psytraxx/gravity-cube-espidf/README.md

# Gravity Cube (ESP-IDF)

Firmware for an 8x8x8 LED cube whose particles fall the way the cube is
tilted. Tilt it and the fluid flows downhill; shake it and the fluid
sloshes; spin it and the fluid swirls against the spin and out to the
walls. A double tap gives the fluid a new, random colour.

It runs on an ESP32-S3 (ESP32-S3 SuperMini) with a BMI160 IMU and
six 8x8 WS2812 panels, and is written in C for ESP-IDF 6.1. The physics is
a port of the fluid solver in
[gravity-cube-rs](https://github.com/psytraxx/gravity-cube-rs).

## Hardware

| Part | Notes |
|---|---|
| ESP32-S3 SuperMini | ESP32-S3FH4R2: 4 MB flash, 2 MB PSRAM (not used) |
| BMI160 breakout | 12-pin board (VIN, 3V3, GND, SCL, SDA, CS, SA0, …), wired for SPI |
| 6 × 8x8 WS2812B panels | 384 LEDs in one chain |
| 330 Ω resistor | In series with the data line, at the first panel |
| 1500 µF capacitor | Across 5 V and GND at the first panel (10 V or more), against the inrush when the LEDs switch |
| 1N5819 Schottky diode | From the 5 V supply to the SuperMini's 5V pin, so USB cannot feed the LEDs or the supply |
| INMP441 breakout | I2S microphone, 1.8–3.3 V; wired, but the firmware does not read it |
| 5 V supply | Sized for the LEDs; the firmware keeps them dim (one channel at 60/255 or less) |

## Wiring

Wiring

### Power

The 5 V supply feeds the panels directly and the SuperMini through the
1N5819, anode on the supply, cathode (the band) on the board's 5V pin.
As a Schottky it drops about 0.3 V at the board's current, so the
SuperMini's regulator gets about 4.7 V. With USB plugged in as well, the
diode keeps USB's 5 V out of the supply and the LEDs; the board then runs
from whichever is higher. The 1500 µF
capacitor sits across 5 V and GND where the supply meets the first
panel, + to 5 V. All grounds are common.

### LEDs

| SuperMini | Goes to |
|---|---|
| GPIO 2 | 330 Ω → DIN of panel 0 |

The panels chain OUT to IN. The four side panels run round the cube, each
with IN at the bottom of the edge it shares with the previous panel. Inside
a panel the chain runs one of two ways, set by *Panel wiring* in
menuconfig:

- **Rows** (default): along the bottom row, then each row above it from the
  same side, to OUT at the top of the edge with the next panel.
- **Zigzag columns**: up the first column, down the next and so on, to OUT
  at the bottom of the edge with the next panel.

Top and Bottom keep their IN corner and turn the same way.

```mermaid
flowchart LR
    ESP[GPIO 2] --> P0["0 Left (x = 0)"] --> P1["1 Back (y = 0)"] --> P2["2 Right (x = 7)"]
    P2 --> P3["3 Front (y = 7)"] --> P4["4 Bottom (z = 0)"] --> P5["5 Top (z = 7)"]
```

The per-panel rotation and mirroring is in
[`main/core/panel.c`](main/core/panel.c).

### BMI160 (SPI)

The IMU uses GPIO 10–13, the ESP32-S3's SPI2 IOMUX pins, and GPIO 9 for
its interrupt line, all on the SuperMini's header:

| BMI160 board | SuperMini |
|---|---|
| 3V3 | 3V3 |
| GND | GND |
| SCL (SCK) | GPIO 12 (SPI_CLK) |
| SDA (SDI / MOSI) | GPIO 11 (SPI_D) |
| SA0 (SDO / MISO) | GPIO 13 (SPI_Q) |
| CS (CSB) | GPIO 10 (SPI_CS) |
| INT1 | GPIO 9 |

VIN (into the board's regulator), INT2 and the auxiliary pins (OCS,
SCX, SDX) stay unconnected. INT1 is push-pull at 3.3 V, so it needs no
resistor. The chip starts on I2C; the first rising edge on CS switches
it to SPI until it is power cycled. SPI runs at 1 MHz (the chip takes
up to 10 MHz). The pins are settable in menuconfig.

### INMP441 microphone (I2S)

| INMP441 board | SuperMini |
|---|---|
| VDD | 3V3 |
| GND | GND |
| SCK | GPIO 5 (I2S bit clock) |
| WS | GPIO 6 (I2S word select) |
| SD | GPIO 7 (I2S data) |
| L/R | GND (left channel) |

The firmware does not read the microphone. The ESP32-S3 routes I2S to any
GPIO, so these pins are just free ones next to each other on the header,
clear of the strapping pins.

### Mounting

The IMU board lies flat on the top face with its Z axis pointing up and
its X axis along the cube's x axis. Mounted any other way, edit
`BMI160_AXIS_MAP` in [`main/core/bmi160_decode.h`](main/core/bmi160_decode.h):
if tilting moves the fluid the wrong way on an axis, flip that axis' sign.

## Build and flash

ESP-IDF 6.1 ([install guide](https://docs.espressif.com/projects/esp-idf/en/v6.1/esp32s3/get-started/)):

```bash
idf.py build
idf.py -p /dev/ttyACM0 flash monitor
```

### Assembly pattern

To check that every panel sits on its face the right way round while
putting the cube together, turn on *Assembly pattern instead of the
fluid* in menuconfig. The cube then shows a still pattern for good:

- The 4x4 centre of each panel glows in that panel's own colour.
- Each edge strip (corners dark) glows in the colour of the panel on the
  other side of that edge.

| Panel | Own colour |
|---|---|
| 0 Left | red |
| 1 Back | green |
| 2 Right | blue |
| 3 Front | yellow |
| 4 Bottom | magenta |
| 5 Top | white |

On a correctly built cube every edge strip matches the centre of the
panel beside it, so along each seam the two strips swap colours. A wrong
centre colour means a panel on the wrong face; edge colours on the wrong
sides mean a panel turned or flipped. The monitor logs the colour table
at startup. Turn the option off again for the fluid.

Keep the cube still for the first second after power on: the gyro
calibrates its zero offset then.

The monitor logs a status line every 100 frames: acceleration,
rotation rate, and the physics, frame and LED send times.

## Updates over Wi-Fi

Once the cube has been flashed over USB with a Wi-Fi SSID set, it takes
new firmware over the network. Set the SSID and password (and, ideally,
an update token) in `idf.py menuconfig` → *Gravity cube* → *Wi-Fi and
firmware updates*, flash over USB once, then for every update:

```bash
idf.py build
curl -H "Authorization: Bearer $TOKEN" \
     --data-binary @build/gravity-cube.bin http://cube.local/ota
```

`curl http://cube.local/` shows the running version (from `git
describe`) and app slot. If `cube.local` does not resolve, use the IP
address the monitor logs once Wi-Fi is up.

```mermaid
sequenceDiagram
    participant PC
    participant Cube
    participant Boot as Bootloader
    PC->>Cube: POST /ota (app image)
    Cube->>Cube: write image to the other slot, check it
    Cube-->>PC: Update written, restarting
    Cube->>Boot: restart
    Boot->>Cube: boot new image (pending)
    Cube->>Cube: Wi-Fi up and 100 frames run within 2 min?
    alt yes
        Cube->>Boot: keep new image
    else no, or it crashes first
        Boot->>Cube: boot previous image
    end
```

The 4 MB flash has two 1984 KB app slots ([`partitions.csv`](partitions.csv)):
the running firmware writes the new image into the other one and boots
it. A new image only stays if it gets onto the network and runs the main
loop for 100 frames within two minutes; if not, or if it crashes first,
the bootloader goes back to the previous image. So a broken build cannot
cut the cube off from further updates, but one built with no SSID turns
updates off for good, until the next USB flash.

Wi-Fi, the network stack and the update server run on core 1, next to
the LED task, so the physics on core 0 keeps its time. Flash writes
pause both cores for moments at a time, so the fluid stutters for the
few seconds an update takes.

Without a token, anyone on the network can reflash the cube.

## Settings

`idf.py menuconfig` → *Gravity cube*:

| Setting | Default | |
|---|---|---|
| LED data GPIO | 2 | |
| Panel wiring | Rows | Rows or zigzag columns, see [LEDs](#leds) |
| Physics step period | 18 ms | The physics constants are per step; a fluid step takes ~17 ms, so 18 ms (55 fps) is the shortest it keeps up with |
| Assembly pattern | off | A still pattern instead of the fluid, for putting the panels in, see [Assembly pattern](#assembly-pattern) |
| Tap threshold | 1000 mg | In 125 mg steps. Raise it if sloshing changes the colour, lower it if taps are missed |
| IMU SPI pins | 11, 13, 12, 10 | MOSI, MISO, SCLK, CS |
| IMU INT1 GPIO | 9 | Double-tap interrupt |
| Wi-Fi SSID, password | empty | Network for updates over Wi-Fi; an empty SSID turns Wi-Fi off |
| Hostname | cube | Answers at `http://cube.local/` |
| Update token | empty | Updates need `Authorization: Bearer <token>`; empty lets anyone on the network update |

The particle count and colour are in [`main/core/config.h`](main/core/config.h).

## How it works

```mermaid
flowchart LR
    IMU[BMI160 FIFO<br/>200 Hz] --> MF[motion filter]
    TAP[BMI160 tap engine] -->|double tap: random hue| FB
    MF -->|gravity + amplified motion| FX[fluid step]
    IMU -->|gyro, integrated| FX
    FX --> FB[frame builder]
    FB -->|queue| LED[LED task<br/>core 1, led_strip]
```

**Core 0** reads every IMU sample since the last frame, runs one physics
step and builds the frame. **Core 1** sends frames to the LEDs with
Espressif's [led_strip](https://components.espressif.com/components/espressif/led_strip)
component over RMT (~11.5 ms for 384 LEDs); the two overlap, and core 0 only waits if core 1
is still sending. Unchanged frames are not re-sent, so a settled cube
keeps the data line quiet.

**IMU.** The BMI160 samples accelerometer (±4 g) and gyro (±1000 °/s)
at 200 Hz into its FIFO, in headerless 12-byte frames. Each frame uses the mean acceleration and the
gyro integrated over all samples since the last frame.

**Motion filter.** A complementary filter tracks gravity: the gyro turns
the estimate as the cube tilts, and the accelerometer slowly corrects it.
Whatever acceleration is left over is the cube's own motion, and is
tripled before reaching the fluid, so shaking sloshes it but tilting does
not overshoot.

**Double tap.** The BMI160's tap engine finds them: a jump in
acceleration above the threshold, after at least 30 ms of stillness,
counts as a tap, and the 50 ms after it belong to the same tap; a second
tap within 375 ms latches a double tap and drives INT1 high. The main
loop checks the pin once a frame, and only when it is high reads and
clears the interrupt over SPI; it answers with a random hue at least 60° from the current
one. Shaking never has the stillness, so it does not
change the colour. Every hue's channels add up to 60/255, so the cube
draws the same current in any colour.

**Fluid.** An incompressible FLIP fluid: inviscid Navier-Stokes on a
staggered grid with one cell per voxel, carried by 512 particles (two per
voxel of a half-full cube). Each step the particles take gravity and the
forces of the turning cube (Euler, Coriolis, centrifugal), hand their
velocity to the grid, and a Gauss-Seidel pressure solve makes the flow
divergence-free against the walls. The particles take back the change
(80 % FLIP, 20 % PIC to damp noise), move, and are pushed apart so they
stay evenly spread; cells packed above two particles get a little
outflow, so the fluid keeps its volume. A voxel lights once the particle
density at its centre reaches 1.2 and goes dark below 0.4, so a settled
surface does not flicker. A step takes ~17 ms on the ESP32-S3.

## Enclosure

[`case/voxel-skin/`](case/voxel-skin/README.md) holds the Voxel Skin
enclosure: a translucent resin cube printed as an open box of five faces and
a lid for the front. On every face the skin, the edge bevels and the edge
walls are one 1.4 mm wall that carries the load, with 1.3 mm light baffles
inside. The USB-C socket and slide switch sit on the bottom front edge. One
generator builds two sizes:

- `65x65/`: an 86 mm cube for rigid 65 × 66 mm panels;
- `80x80/`: a 100 mm cube for flexible 80 × 80 mm panels.

`.github/workflows/pages.yml` publishes `case/` to GitHub Pages, with 3D
viewers at <https://psytraxx.github.io/gravity-cube-espidf/>.

## Code layout

| Path | |
|---|---|
| `main/main.c` | Main loop on core 0, LED task on core 1 |
| `main/ota.c` | Wi-Fi, mDNS and the update server on core 1; keeps or rolls back a new image |
| `main/bmi160.c` | BMI160 over SPI: setup, gyro calibration, FIFO reads |
| `main/ws2812.c` | WS2812 chain through the `espressif/led_strip` component (RMT) |
| `main/core/` | Everything that needs no hardware: fluid, colours, frames, the panel map and the fluid's picture on it, assembly pattern, motion filter, IMU sample decoding and batching |
| `test/host/` | Unity tests for `main/core`, run on the host |
| `case/` | Enclosure: generator, STLs and 3D viewers |

## Tests

The core has host tests (plain CMake and Unity, no ESP-IDF):

```bash
cmake -S test/host -B build-host && cmake --build build-host
ctest --test-dir build-host --output-on-failure
```

CI runs them and builds the firmware on every push.
