psytraxx/gravity-cube-espidf/case/voxel-skin/65x65/box.stl

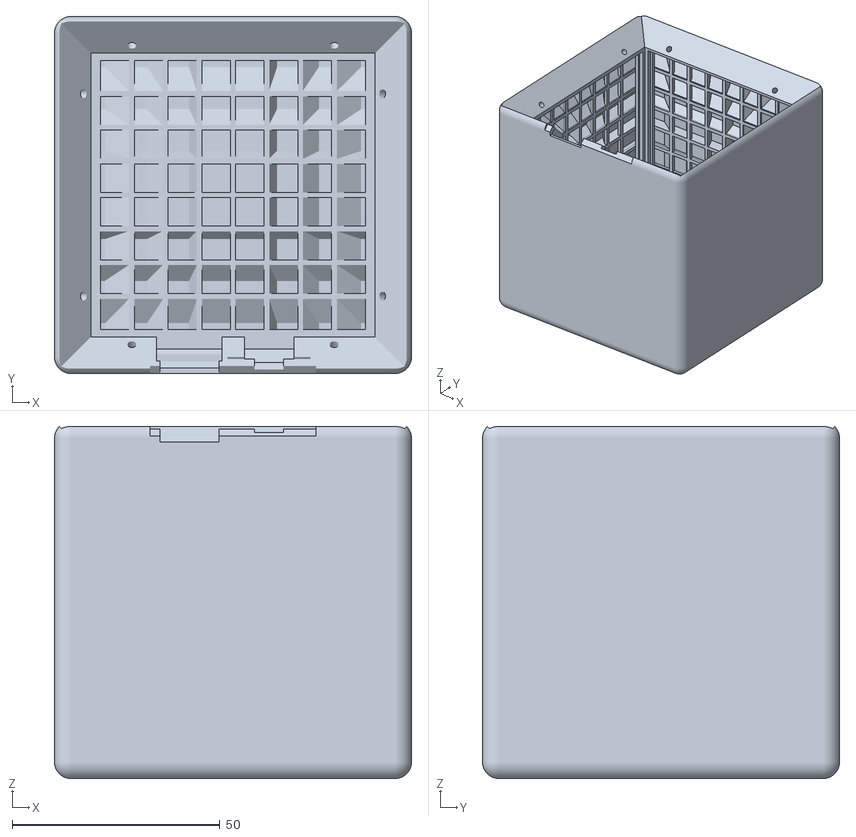
[picture p2: CAD file, 2026-11-14]
case/voxel-skin/65x65/box.stl
86.0 x 86.0 x 84.8
