psytraxx/gravity-cube-espidf/case/voxel-skin/80x80/box.stl

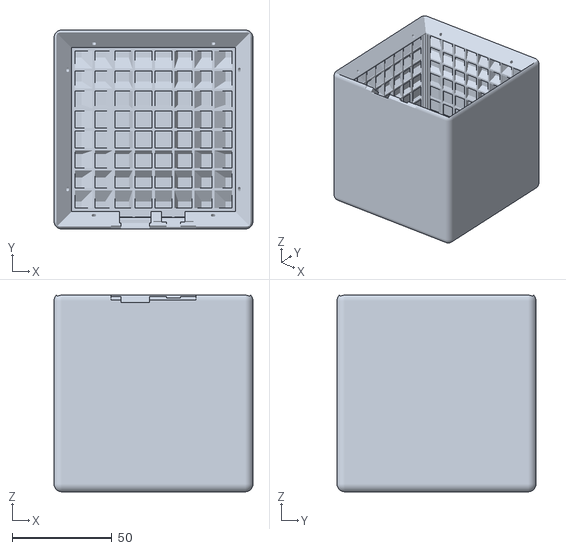
[picture p3: CAD file, 2026-11-14]
case/voxel-skin/80x80/box.stl
100.0 x 100.0 x 98.8
