psytraxx/gravity-cube-espidf/case/voxel-skin/65x65/fit_test.stl

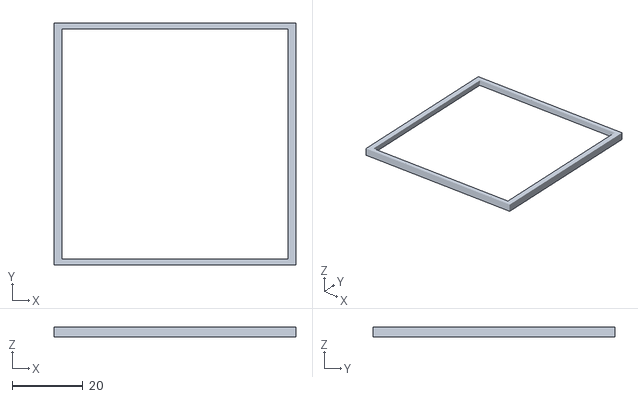
[picture p4: CAD file, 2026-11-14]
case/voxel-skin/65x65/fit_test.stl
68.2 x 68.2 x 2.90
