psytraxx/gravity-cube-espidf/case/voxel-skin/80x80/lid.stl

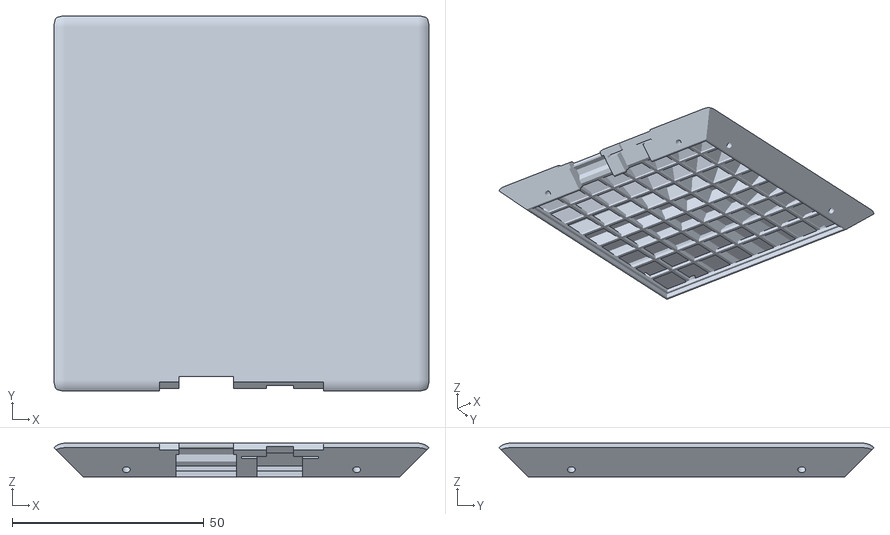
[picture p5: CAD file, 2026-11-14]
case/voxel-skin/80x80/lid.stl
97.7 x 97.7 x 8.75
