psytraxx/gravity-cube-espidf/case/voxel-skin/65x65/lid.stl

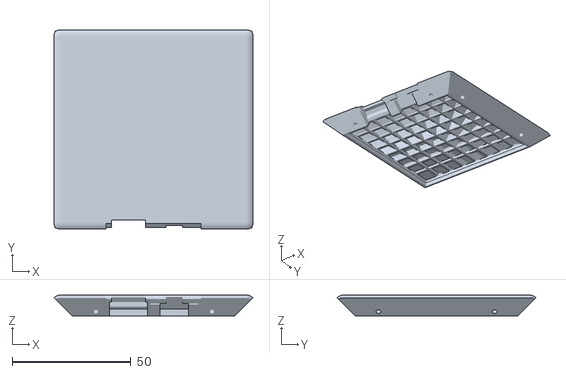
[picture p6: CAD file, 2026-11-14]
case/voxel-skin/65x65/lid.stl
83.7 x 83.7 x 8.80
