psytraxx/gravity-cube-espidf/case/voxel-skin/80x80/fit_test.stl

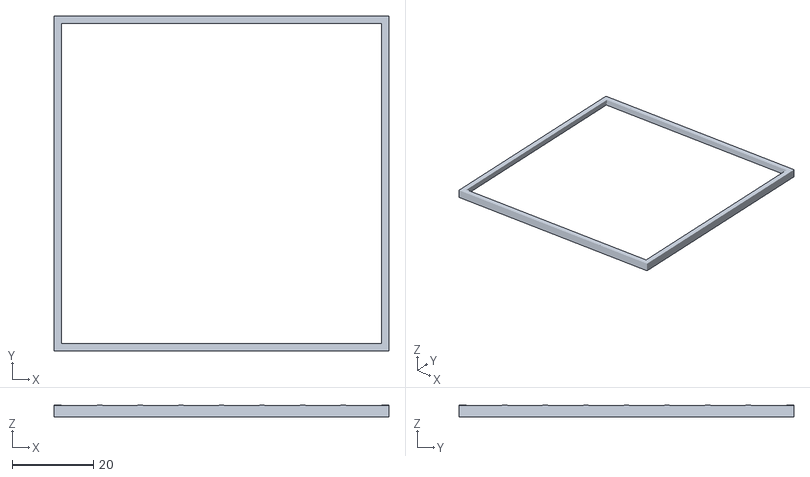
[picture p7: CAD file, 2026-11-14]
case/voxel-skin/80x80/fit_test.stl
82.5 x 82.5 x 2.85
