psytraxx/gravity-cube-espidf/case/voxel-skin/65x65/part_usb_c_lead_black.stl

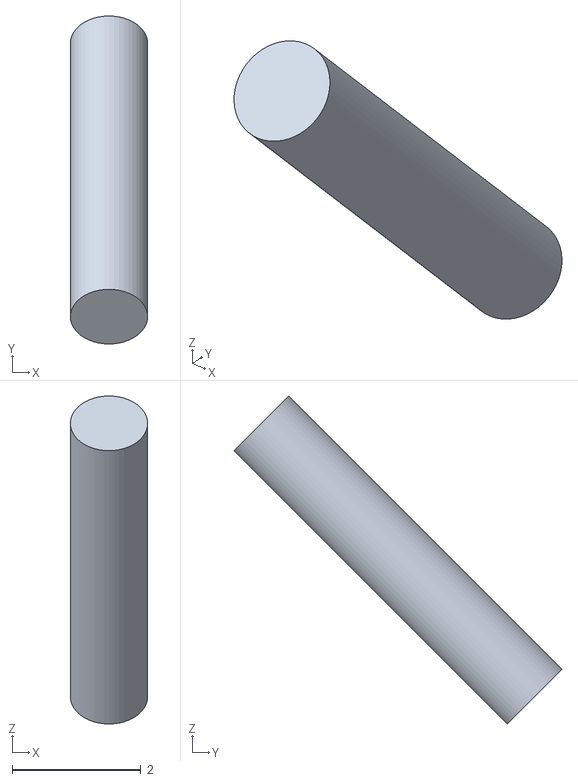
[picture p8: CAD file, 2026-11-14]
case/voxel-skin/65x65/part_usb_c_lead_black.stl
1.20 x 5.09 x 5.09
