psytraxx/gravity-cube-espidf/case/voxel-skin/80x80/part_slide_switch_ss12f15.stl

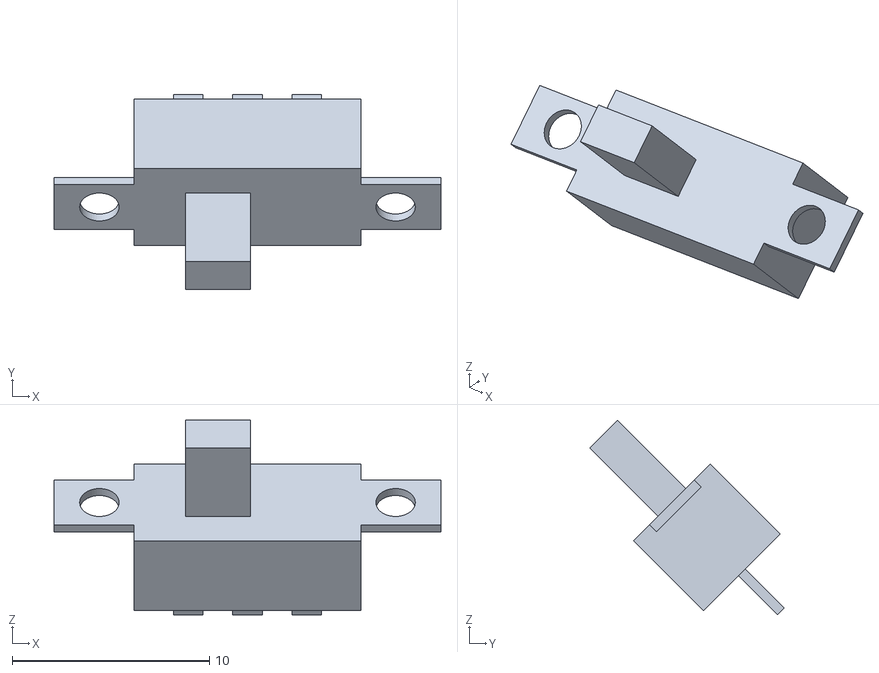
[picture p9: CAD file, 2026-11-14]
case/voxel-skin/80x80/part_slide_switch_ss12f15.stl
19.6 x 9.86 x 9.86
