psytraxx/gravity-cube-espidf/case/voxel-skin/80x80/part_usb_c_metal.stl

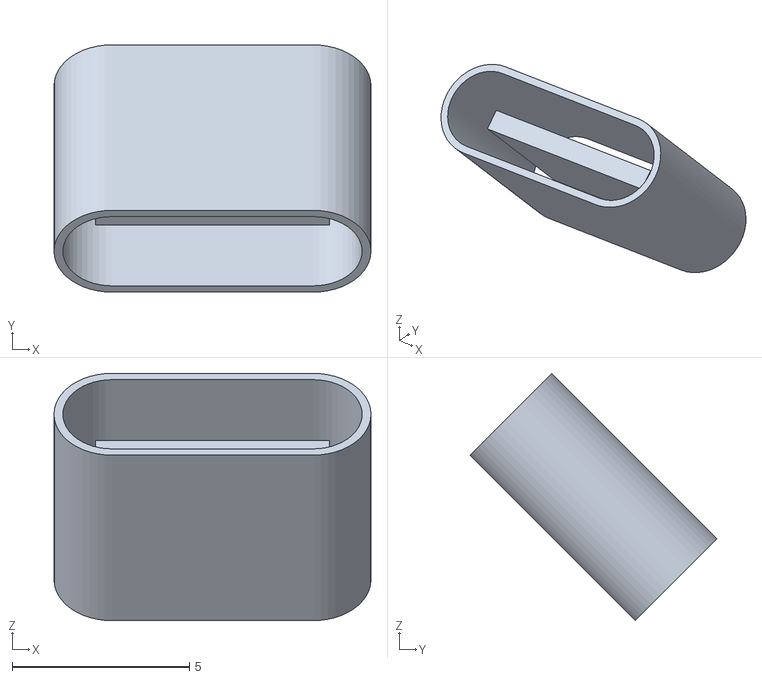
[picture p10: CAD file, 2026-11-14]
case/voxel-skin/80x80/part_usb_c_metal.stl
8.94 x 6.97 x 6.97
