psytraxx/gravity-cube-espidf/case/voxel-skin/80x80/part_usb_c_socket.stl

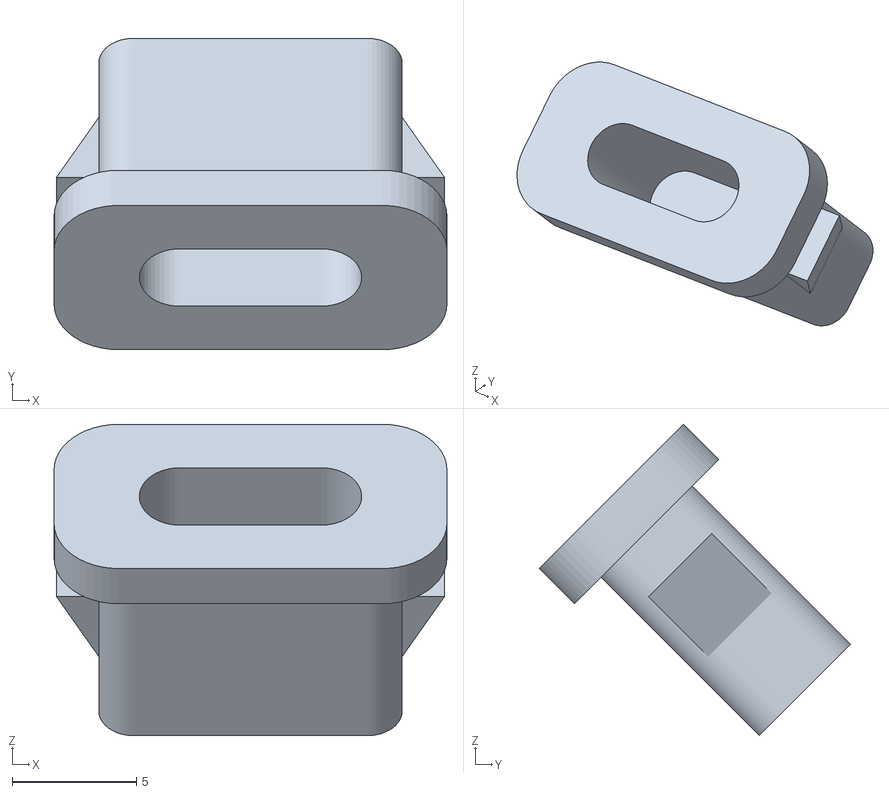
[picture p11: CAD file, 2026-11-14]
case/voxel-skin/80x80/part_usb_c_socket.stl
15.8 x 12.5 x 12.5
