psytraxx/gravity-cube-espidf/(list of files, cad)

Other CAD files:
case/voxel-skin/65x65/part_usb_c_lead_red.stl
case/voxel-skin/65x65/part_usb_c_metal.stl
case/voxel-skin/65x65/part_usb_c_socket.stl
case/voxel-skin/80x80/part_usb_c_lead_black.stl
case/voxel-skin/65x65/part_slide_switch_ss12f15.stl
case/voxel-skin/80x80/part_usb_c_lead_red.stl
