psytraxx/gravity-cube-espidf/main/main.c

/* Gravity cube: particles on an 8x8x8 LED cube that fall the way the cube
 * is tilted.
 *
 * Core 0 (this task) reads the IMU, runs the physics and builds frames;
 * core 1 sends them to the LEDs. The RMT send takes ~11.5 ms per changed
 * frame, so the two overlap: core 0 computes the next frame while core 1
 * sends the current one, and only waits if core 1 is still busy. Wi-Fi
 * and firmware updates run on core 1 too (ota.c). */
#include "assembly.h"
#include "esp_log.h"
#include "esp_random.h"
#include "esp_timer.h"
#include "fluid.h"
#include "imu.h"
#include "freertos/FreeRTOS.h"
#include "freertos/queue.h"
#include "freertos/task.h"
#include "motion.h"
#include "bmi160.h"
#include "ota.h"
#include "panel.h"
#include "sdkconfig.h"
#include "view.h"
#include "ws2812.h"

static const char *TAG = "cube";

/* Track gravity with the gyro and triple anything else, so shaking the
 * cube sloshes the fluid. */
#define MOTION_SMOOTHING 0.05f
#define MOTION_GAIN      3.0f

/* FIFO samples read per frame at most; the FIFO holds 85. */
#define MAX_SAMPLES 48

#define LOG_EVERY 100

/* Frames from core 0 to core 1. One slot. */
static QueueHandle_t s_frames;
/* Duration of the last LED send, for the status log. */
static volatile int64_t s_led_send_us;

static void led_task(void *arg)
{
    /* The RMT interrupt runs on the core that sets the channel up. */
    ESP_ERROR_CHECK(ws2812_init(CONFIG_CUBE_LED_GPIO));
    ESP_LOGI(TAG, "%d LEDs on GPIO %d, sent from core %d", LED_COUNT, CONFIG_CUBE_LED_GPIO,
             xPortGetCoreID());
    static frame_t frame;
    for (;;) {
        xQueueReceive(s_frames, &frame, portMAX_DELAY);
        const int64_t start = esp_timer_get_time();
        const esp_err_t err = ws2812_show(&frame);
        if (err != ESP_OK) {
            ESP_LOGW(TAG, "LED refresh failed: %s", esp_err_to_name(err));
        }
        s_led_send_us = esp_timer_get_time() - start;
    }
}

#if CONFIG_CUBE_ASSEMBLY_PATTERN
/* Show the assembly pattern for good. The image counts as working once
 * the pattern is out, so updates over Wi-Fi keep it. */
static void assembly_pattern(void)
{
    ESP_LOGI(TAG, "Assembly pattern: each edge shows the colour of the panel across it");
    for (int p = 0; p < PANEL_COUNT; p++) {
        ESP_LOGI(TAG, "  %d %-6s %s", p, panel_name(p), assembly_color_name(p));
    }
    static frame_t frame;
    assembly_frame(&frame);
    xQueueSend(s_frames, &frame, portMAX_DELAY);
    ota_app_ok();
    for (;;) {
        vTaskDelay(portMAX_DELAY);
    }
}
#endif

void app_main(void)
{
    ESP_LOGI(TAG, "Gravity cube, %dx%dx%d", CUBE_SIZE, CUBE_SIZE, CUBE_SIZE);

#if CONFIG_CUBE_PANEL_WIRING_ROWS
    panel_set_wiring(PANEL_WIRING_ROWS);
#else
    panel_set_wiring(PANEL_WIRING_ZIGZAG);
#endif

    /* Joins Wi-Fi on core 1 while the rest starts up. */
    ota_start();

    s_frames = xQueueCreate(1, sizeof(frame_t));
    xTaskCreatePinnedToCore(led_task, "leds", 4096, NULL, 5, NULL, 1);

#if CONFIG_CUBE_ASSEMBLY_PATTERN
    assembly_pattern();
#endif

    /* Calibrates the gyro, so the cube should be still. */
    const bool have_imu = bmi160_init() == ESP_OK;
    if (!have_imu) {
        ESP_LOGW(TAG, "No BMI160: check the wiring (README.md#wiring). "
                      "Running with gravity towards z == 0, no spin or taps.");
    }

    static fluid_t fluid;
    fluid_init(&fluid);
    fluid_populate(&fluid, FLUID_PARTICLES);
    ESP_LOGI(TAG, "%d fluid particles; double-tap the cube to change colour", FLUID_PARTICLES);
    uint32_t hue = FLUID_HUE;

    motion_filter_t motion;
    motion_filter_init(&motion, MOTION_SMOOTHING, MOTION_GAIN);

    static imu_sample_t samples[MAX_SAMPLES];
    static frame_t frame;
    /* No IMU (or no new sample): gravity towards z == 0. */
    imu_batch_t imu;
    imu_batch_init(&imu);
    uint32_t loops = 0;
    TickType_t wake = xTaskGetTickCount();

    for (;;) {
        if (have_imu && bmi160_double_tap()) {
            /* At least 60 degrees from the last hue, so the change shows. */
            hue = (hue + 60 + esp_random() % 241) % 360;
            ESP_LOGI(TAG, "Double tap: hue %lu", (unsigned long)hue);
        }

        /* Every sample since the last frame: the gyro is integrated over
         * all of them, and their mean is this frame's acceleration. */
        const int n = have_imu ? bmi160_read(samples, MAX_SAMPLES) : 0;
        if (n < 0) {
            ESP_LOGW(TAG, "IMU read failed");
        }
        imu_batch(&imu, samples, n, BMI160_SAMPLE_MS / 1000.0f);

        const int64_t start = esp_timer_get_time();
        fluid_set_rotation(&fluid, imu.rotation);
        fluid_step(&fluid, motion_filter_apply(&motion, imu.accel, imu.rotation));
        const int64_t physics_us = esp_timer_get_time() - start;

        view_frame(&fluid, hue, &frame);
        xQueueSend(s_frames, &frame, portMAX_DELAY);
        const int64_t frame_us = esp_timer_get_time() - start;

        if (++loops % LOG_EVERY == 0) {
            ESP_LOGI(TAG,
                     "Loop %lu: accel (%.2f, %.2f, %.2f) |%.2f| g, gyro (%.2f, %.2f, %.2f) rad/s, "
                     "physics %lld us, frame %lld us, LED send %lld us",
                     (unsigned long)loops, imu.accel.x, imu.accel.y, imu.accel.z, v3_len(imu.accel),
                     imu.rate.x, imu.rate.y, imu.rate.z, physics_us, frame_us, s_led_send_us);
        }
        if (loops == LOG_EVERY) {
            ota_app_ok();
        }

        /* Fixed step rate: the physics constants are per step. If a frame
         * ran over, still give the idle task a tick. */
        if (xTaskDelayUntil(&wake, pdMS_TO_TICKS(CONFIG_CUBE_FRAME_MS)) == pdFALSE) {
            vTaskDelay(1);
            wake = xTaskGetTickCount();
        }
    }
}
