psytraxx/gravity-cube-espidf/main/core/panel.h

/* Maps voxels on the cube's surface to LEDs in the chain, and builds
 * frames.
 *
 * Six 8x8 panels, chained OUT to IN. The four side panels run round the
 * cube, each with IN at the bottom of the edge it shares with the
 * previous panel. How the chain runs inside a panel is the wiring, set
 * once with panel_set_wiring. Faces are named as in the unfolded cross
 * (Front = North):
 *
 *   0 Left (x == 0), 1 Back (y == 0), 2 Right (x == 7), 3 Front (y == 7),
 *   4 Bottom (z == 0), 5 Top (z == 7)
 *
 * A voxel on an edge or corner lights an LED on every face it touches;
 * inner voxels light nothing. */
#pragma once

#include <stdint.h>

#include "config.h"
#include "frame.h"
#include "particle.h"

#define PANEL_COUNT 6
#define PANEL_LEDS  (CUBE_SIZE * CUBE_SIZE)

/* How the chain runs through each panel, from IN. On a side panel:
 *   PANEL_WIRING_ZIGZAG: up the first column, down the next and so on,
 *     to OUT at the bottom of the edge with the next panel.
 *   PANEL_WIRING_ROWS: along the bottom row, then each row above it from
 *     the same side, to OUT at the top of the edge with the next panel.
 * Top and Bottom keep their IN corner and turn the same way. */
typedef enum {
    PANEL_WIRING_ZIGZAG,
    PANEL_WIRING_ROWS,
} panel_wiring_t;

/* Before any of the functions below; PANEL_WIRING_ZIGZAG until then. */
void panel_set_wiring(panel_wiring_t wiring);

/* LEDs showing a voxel, at most three (a corner). Returns how many. */
int panel_leds(cell_t cell, uint16_t leds[3]);

/* Light every LED that shows the voxel. */
void frame_set(frame_t *f, cell_t cell, color_t color);

/* Light one LED of a panel (0-5, chain order), by where it sits seen from
 * outside the cube: column 0 on the left, row 0 at the bottom. The side
 * panels are upright and run on from one to the next round the cube; Top
 * and Bottom lie as in the unfolded cross, Top above Front and Bottom
 * below it. */
void frame_set_panel_led(frame_t *f, int panel, uint8_t col, uint8_t row, color_t color);

/* The voxel under that LED, with the same panel, column and row. */
cell_t panel_cell(int panel, uint8_t col, uint8_t row);

/* The face a panel sits on, e.g. "Back". */
const char *panel_name(int panel);
