psytraxx/gravity-cube-espidf/(commit log)

2026-10-27 Gravity cube firmware for ESP32 on ESP-IDF 6.1
    C firmware for an 8x8x8 WS2812 cube on a plain ESP32 with an MPU-6500
    IMU, carrying the fluid solver, boids, motion filter and spin response
    of gravity-cube-rs.
    - main/core: IDF-free physics, panel map, software double-tap detector
    and MPU-6500 sample decoding, with Unity host tests
    - MPU-6500 over I2C (default, GPIO 21/22) or SPI, sampled at 250 Hz
    into its FIFO, gyro bias calibrated at boot
    - LED chain on GPIO 2 (WLED default) via RMT, sent from core 1 while
    core 0 runs the physics
    - CI: host tests and firmware builds for both IMU buses
    Claude-Session: https://claude.ai/code/sessi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
2026-10-27 Talk to the MPU-6500 over SPI only
    SPI at 1 MHz reads a frame's FIFO samples in a fraction of the time the
    400 kHz I2C interface takes. Pins default to the ESP32's VSPI set
    (MOSI 23, MISO 19, SCLK 18, CS 5) and stay settable in menuconfig.
    Claude-Session: https://claude.ai/code/session_01BWpaorZbpr9YMM3qLoZtZr
2026-10-27 Drive the LEDs with Espressif's led_strip component
    ws2812.c sets the chain through espressif/led_strip (^3.1.1) on RMT,
    GPIO 2, with four RMT memory blocks for refill slack. Frames hold RGB
    per LED; led_strip orders the bytes for the wire and sends the reset
    code. dependencies.lock is regenerated by the component manager.
    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
    [panel.c, panel.h, ws2812.c, ws2812.h]
2026-10-27 Run on the ESP32-S3 and map the panels as wired
    The cube runs on a LilyGO T-Display-S3 (ESP32-S3, 16 MB flash). The IMU
    sits on the board's SPI header (MOSI 11, MISO 13, SCLK 12, CS 10), clear
    of the LCD; the LEDs stay on GPIO 2. CI builds for esp32s3.
    Panel map: the panels are zigzag wired and the four side panels run
    round the cube in columns, Left, Back, Right, Front, then Bottom and
    Top. z == 0 is the Bottom face.
    IMU axes: with these face names the cube's axes are a mirror image of
    the sensor's, so the axis map turns X round as well as Z, and the gyro
    sign is derived from the map's determinant so it always matches.
    At power on, each panel lights green for 2 s in chain order before th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
2026-10-27 Add dependencies.lock for espressif/led_strip and idf components
2026-10-27 Drop the boids; a double tap gives the fluid a random colour
    The cube runs the fluid only: main.c drives fluid_t directly, with no
    effect switching. A double tap picks a random hue at least 60 degrees
    from the current one. color_from_hue() blends two channels whose sum is
    always 60/255, so every colour draws the same current as the old dim
    green.
2026-10-28 Simulate the fluid as an incompressible FLIP fluid
    The fluid is inviscid Navier-Stokes on a staggered grid with one cell
    per voxel, carried by 512 particles (two per voxel, half the cube).
    Each step the particles take gravity and the turning cube's Euler,
    Coriolis and centrifugal forces, hand their velocity to the grid, and a
    30-pass Gauss-Seidel pressure solve makes the flow divergence-free
    against the walls. The particles take back the change (80 % FLIP,
    20 % PIC), move, and are pushed apart; cells packed above rest density
    get extra outflow so the volume holds. Grid samples past a wall get no
    weight, so cells along the walls do not read as packed.
    A voxel lights once the particle density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
    [config.h, fluid.c, fluid.h, main.c, particle.h]
2026-10-28 Tint the fluid per particle so its shades flow and mix
    Each particle carries a hue offset of up to 40 degrees either side of
    the fluid's hue, starting as a diagonal gradient across the fluid; the
    offsets travel with the particles, so sloshing swirls and mixes the
    shades. Each voxel shows its particles' density-weighted mean tint plus
    60 degrees per cell per step of speed, so moving fluid shimmers. The
    double tap still picks the base hue, and every shade keeps the same
    total brightness.
2026-10-28 Update the firmware over Wi-Fi
    The cube joins the Wi-Fi network set in menuconfig, answers at
    http://<hostname>.local/ over mDNS and takes a new app image as an HTTP
    POST to /ota, optionally guarded by a bearer token. The image goes into
    the other of two 4 MB app slots, erased as it is written so the physics
    only stalls for moments at a time.
    A new image is kept once it is on the network and the main loop has run
    100 frames within two minutes; otherwise, or if it crashes first, the
    bootloader goes back to the previous image, so a broken build cannot cut
    the cube off from updates.
    Wi-Fi, lwIP, mDNS and the HTTP server run on core 1 next to the LED
    task, leaving core 0 to the physics. The ve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
    [partitions.csv]
2026-10-28 Fill each panel LED by LED in the power-on test
    Each panel in chain order fills green from the bottom left, as seen from
    outside the cube, row by row to the top right, one LED per frame: about
    0.8 s a panel instead of 2 s, and a single dead LED shows up too. The
    sides fill upright and run on round the cube; Top and Bottom lie as in
    the unfolded cross, with their Front edge at the bottom and top.
    frame_set_panel_led() addresses one LED of a panel by that position and
    replaces frame_fill_panel().
    [main.c, panel.c, panel.h]
2026-11-05 Add the Voxel Shell enclosure and publish it to Pages
    case/ holds the enclosure for the cube: the 65x65 and 80x80 Voxel Shell
    variants with generate.py, check_fit.py, the STLs and the 3D viewers,
    plus the frame concept comparison. pages.yml publishes case/ to GitHub
    Pages on every push to main that touches it.
    Claude-Session: https://claude.ai/code/session_01BWpaosRB6kgUA5d6DK28xZ
    [assembly_preview.stl, fit_test.stl, part_slide_switch_ss12f15.stl, part_usb_c_lead_black.stl, part_usb_c_lead_red.stl, part_usb_c_metal.stl, part_usb_c_socket.stl, shell.stl]
2026-11-05 Run on the ESP32-S3 SuperMini
    The SuperMini's ESP32-S3FH4R2 has 4 MB flash, so the two app slots are
    1984 KB each and the flash size is 4 MB. Its header carries GPIO 1-13,
    so the LED and IMU pins stay as they are.
    [partitions.csv]
2026-11-05 Document the INMP441 microphone wiring
2026-11-05 Add a wiring diagram with the LED power parts
    docs/wiring.svg shows the whole cube: supply, SuperMini, LED panels,
    MPU-6500 and INMP441. The LED data line runs from GPIO 2 through the
    330 ohm resistor straight to panel 0. A 1N4007 from the supply to the
    SuperMini's 5V pin keeps USB power out of the LEDs, and a 1500 uF
    capacitor sits across the supply at the first panel.
2026-11-05 Use a BMI160 IMU over SPI
    The IMU is a BMI160 on a 12-pin breakout, on the same SPI pins. It
    samples accel (±4 g) and gyro (±1000 °/s) at 200 Hz into its FIFO as
    headerless 12-byte frames (gyro then accel, little-endian), decoded in
    main/core/bmi160_decode.c. A board that turns out to carry an ST
    LSM6DS3 is named in the log.
    Claude-Session: https://claude.ai/code/session_01BWpaoq3PrZbpeUV9RDYNTk
2026-11-05 Detect double taps with the BMI160's tap engine
    The chip's engine finds double taps: slope above the menuconfig
    threshold (125 mg steps at ±4 g), 30 ms quiet, 50 ms shock, second tap
    within 375 ms. The event is latched in INT_STATUS_0; the main loop reads
    it once a frame and clears it with INT_RESET. The software tap detector
    and its tests are gone.
    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
2026-11-05 Take the double tap from the BMI160's INT1 pin
    INT1 (push-pull, active high, latched) goes to GPIO 9, settable in
    menuconfig, with the internal pull-down on. The main loop checks the
    pin each frame and reads and clears INT_STATUS_0 over SPI only when it
    is high. README and the wiring diagram show the new line.
    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
2026-11-05 Feed the SuperMini through a 1N5819, guard INT1
    The SuperMini's 5V pin is fed through a 1N5819 Schottky diode, which
    drops about 0.3 V, so the board's regulator gets about 4.7 V.
    The IMU runs on SPI2_HOST, whose IOMUX pins GPIO 10-13 are. Register
    writes carry their two bytes in the transaction itself. A double tap
    counts on a rising edge of INT1 only, so a line stuck high changes the
    colour once rather than every frame.
    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
    [bmi160.c, bmi160.h, main.c]
2026-11-05 Add panel wiring configuration and update logic for LED chain layout
2026-11-07 Join routers with a broken WPA3 compatibility mode
    The FRITZ!Box 4040 advertises an RSNXE override element in its beacon
    but leaves it out of 4-way handshake message 3, so every join failed
    with reason 17 (IE differs in 4-way handshake). The station now ignores
    WPA3 compatibility (RSN override) elements and joins with the base RSN
    element.
    Reconnects after a dropped or failed join back off from 1 s to 60 s,
    resetting once an IP is assigned.
    [ota.c]
2026-11-07 Show an assembly pattern for fitting the panels
    With "Assembly pattern instead of the fluid" set in menuconfig, the cube
    shows a still pattern after the panel test. Each panel lights its 4x4
    centre in its own colour (Left red, Back green, Right blue, Front
    yellow, Bottom magenta, Top white) and each edge strip in the colour of
    the panel across that edge, corners dark. On a correctly built cube
    every edge strip matches the centre beside it; a wrong centre colour
    means a panel on the wrong face, edge colours on the wrong sides a panel
    turned or flipped.
    The pattern takes its geometry from the panel map through panel_cell,
    the voxel under a panel LED, which frame_set_panel_led now uses too.
    C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
    [assembly.c, assembly.h, main.c, panel.c, panel.h]
2026-11-08 Drop the power-on panel test (#11)
    At power on the cube goes straight to the fluid, or to the assembly
    pattern when that is set: the assembly pattern is the one picture for
    checking the panels.
    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
2026-11-08 Tidy the layers: frames, the fluid's picture and IMU batching in the core (#12)
    - main/core/frame.[ch] holds frame_t, frame_clear and frame_set_led; the
    panel map and the WS2812 driver build on it, so the driver no longer
    depends on the panel map. color_t lives in color.h.
    - main/core/view.[ch] turns the fluid into a frame on the panels (host
    tested); main.c calls it.
    - main/core/imu.[ch] folds a frame's IMU samples into the mean
    acceleration, the rotation over them and the last rate (host tested).
    - The BMI160 driver drops the I2C scan option and the LSM6DS3 check; the
    IMU is a BMI160 on SPI.
    Claude-Session: https://claude.a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
    [bmi160.c, color.h, config.h, frame.h, imu.h, main.c, panel.c, panel.h]
2026-11-14 Add Voxel Skin 80x80 enclosure: folded-plate shells with 1.4 mm walls
    Six mitred shells for the flexible 80 x 80 mm panels in which the skin,
    bevels and mitre walls form one 1.4 mm structural wall, with 0.85 mm
    light baffles inside. 100 mm cube, 24.3 cm3 of resin per shell, same
    panels, USB-C socket, switch and dowels as the Voxel Shell 80x80.
    Claude-Session: https://claude.ai/code/session_01BWpaosr9mWHCACSGeV29nH
    [assembly_preview.stl, fit_test.stl, part_slide_switch_ss12f15.stl, part_usb_c_lead_black.stl, part_usb_c_lead_red.stl, part_usb_c_metal.stl, part_usb_c_socket.stl, shell.stl]
2026-11-14 Replace the Voxel Shell enclosures with the Voxel Skin for both panel sizes
    case/voxel-skin/ builds six mitred translucent resin shells for the rigid
    65 x 66 mm panels (86 mm cube, 21.3 cm3 per shell) and the flexible
    80 x 80 mm panels (100 mm cube, 26.7 cm3 per shell). In each shell the skin,
    edge bevels and mitre walls are one 1.4 mm folded wall that carries the
    load; 1.3 mm baffles inside fan the light out to the mitre walls. Same
    panels, USB-C socket, switch and dowels as before.
    check_fit.py checks the fit of panels, parts and shells, outer walls of at
    least 1.3 mm and features of at least 0.8 mm. One viewer.html shows both
    sizes from the profile.json the generator writes. The index pa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
    [assembly_preview.stl, fit_test.stl, part_slide_switch_ss12f15.stl, part_usb_c_lead_black.stl, part_usb_c_lead_red.stl, part_usb_c_metal.stl, part_usb_c_socket.stl, shell.stl]
2026-11-14 Print the Voxel Skin as an open box of five faces and a lid
    The back, top, bottom, left and right faces are cut from one solid as
    box.stl; the front face is lid.stl. The eight edges inside the box are a
    single 1.4 mm wall shared by two faces, and only the four edges round the
    opening keep mitre walls and dowels (8 instead of 24). Resin drops to
    124 cm3 (65x65) and 155 cm3 (80x80).
    check_fit.py checks every panel against the box and lid, and the path each
    panel takes in through the open front: the back panel straight in, each
    side panel held 3.25 mm in from its face, slid in and pressed out into its
    pocket. The wall check now covers the shared edge walls too. The viewer
    loads box and lid and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
    [assembly_preview.stl, box.stl, lid.stl, shell.stl, shell_port_bottom.stl]
2026-11-14 Revert "Print the Voxel Skin as an open box of five faces and a lid"
    The box and lid move to their own pull request, stacked on this one.
    This reverts commit c39d827.
    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
    [assembly_preview.stl, box.stl, shell.stl, shell_port_bottom.stl, shell_port_front.stl]
2026-11-14 Print the Voxel Skin as an open box of five faces and a lid
    opening keep mitre walls and dowels (8 instead of 24).
    side panel held a few millimetres in from its face, slid in and pressed out
    into its pocket. The viewer loads box and lid and its slider lifts the lid.
    Claude-Sess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
    [assembly_preview.stl, box.stl, lid.stl, shell.stl, shell_port_bottom.stl]
2026-11-14 Round the Voxel Skin edges and bend the baffles at constant thickness
    All twelve edges are rounded to a 4 mm radius with spherical corners; the
    light cells are clipped 1.4 mm inside the rounded outside. The USB-C socket
    and switch sit on a flat 45 degree pad cut into the rounding of the bottom
    front edge, over just the length the two parts need.
    Each baffle is now a strip of constant thickness bent above the LEDs: the
    face on the inside of the bend starts to slope a little lower, so the baffle
    stays 1.3 mm thick through the bend. The bend sits high enough to keep that
    face above the LEDs. The fit-test slice keeps the pocket lip and clamp
    ring only, as a stub of the baffles would be thinner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
    [box.stl, fit_test.stl, lid.stl]
2026-11-14 Update the Voxel Skin README numbers and preview for the rounded box and lid
    Both profiles pass check_fit.py: outer and edge walls at least 1.30 mm
    (65x65) and 1.37 mm (80x80), thinnest part 0.88 mm.
    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
2026-11-14 Remove the frame concepts page
    case/concepts.html compared enclosure designs that are no longer in the
    repository. The index page now links only to the Voxel Skin viewers, and
    its text describes the rounded edges.
    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
2026-11-14 Correct the Voxel Skin assembly: swing the lid shut, no dowels
    The switch pocket and the USB-C pocket are split between box and lid.
    Pushed straight on, the lid hits the switch plate glued in the box; it
    clears the switch and the box when it is rested on the bottom front edge
    and swung shut about it. A dowel square to a 45 degree mitre blocks that
    swing, so the dowel holes stay empty and the four mitres centre the lid.
    README, viewer and code comments now give the assembly in that order:
    panels, switch, front panel in the lid, swing the lid shut, then the USB-C
    socket from outside. Comments that still spoke of shells now speak of faces.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
